santiagomd11/Proyecto-bola-balanza---Taller-de-control/documentos/Proyecto_bola_balanza_Taller_control__Monta_o_Diaz.pdf

# Proyecto Bola-balanza-Taller de control

V´ıctor Santiago Montano Diaz - ˜ | vs.montano@uniandes.edu.co

## Universidad de los Andes

Departamento de Ingenier´ıa Electrica y Electr ´ | onica ´

### Abril de 2020

## 1. Diagrama de bloques del sistema de control

Se cuenta con tres niveles los cuales se muestran a continuacion: ´

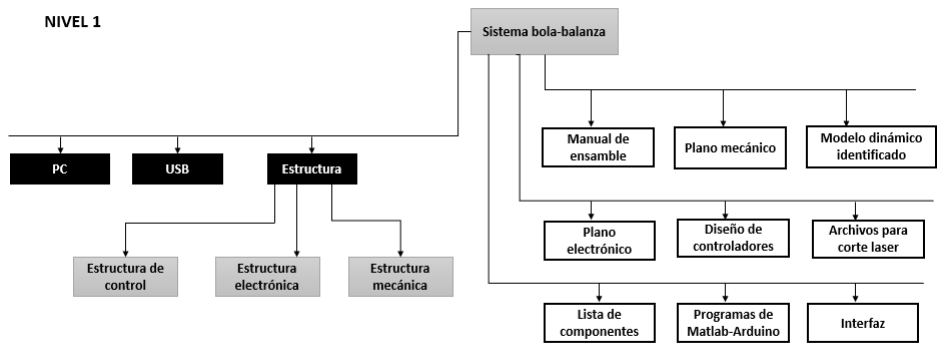
[picture p1: figure]

Figura 1: Nivel 1

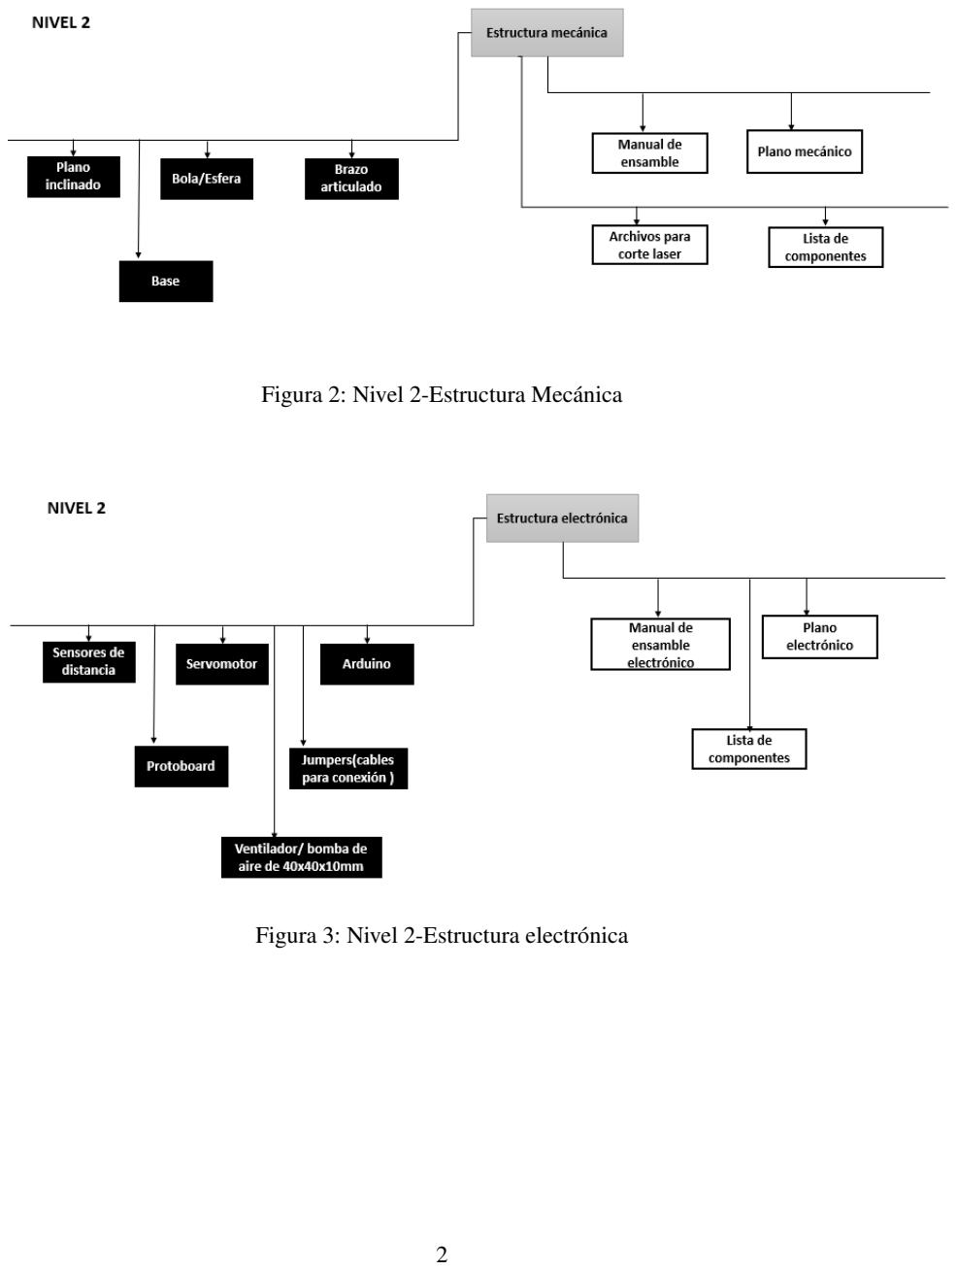
[picture p2: page 2]

Figura 2: Nivel 2-Estructura Mecanica ´

Figura 3: Nivel 2-Estructura electronica ´

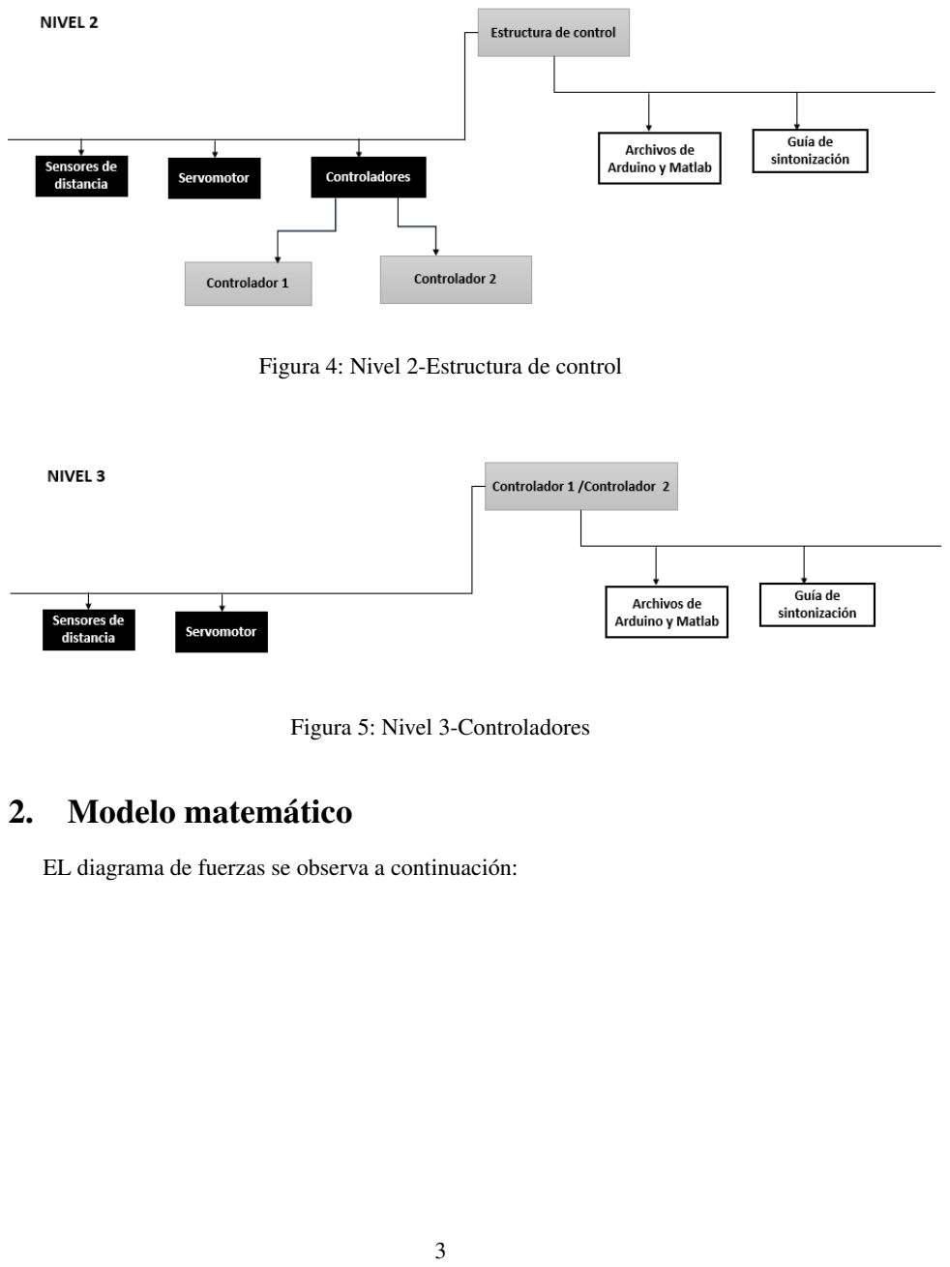
[picture p3: page 3]

Figura 4: Nivel 2-Estructura de control

Figura 5: Nivel 3-Controladores

## 2. Modelo matematico ´

EL diagrama de fuerzas se observa a continuacion: ´

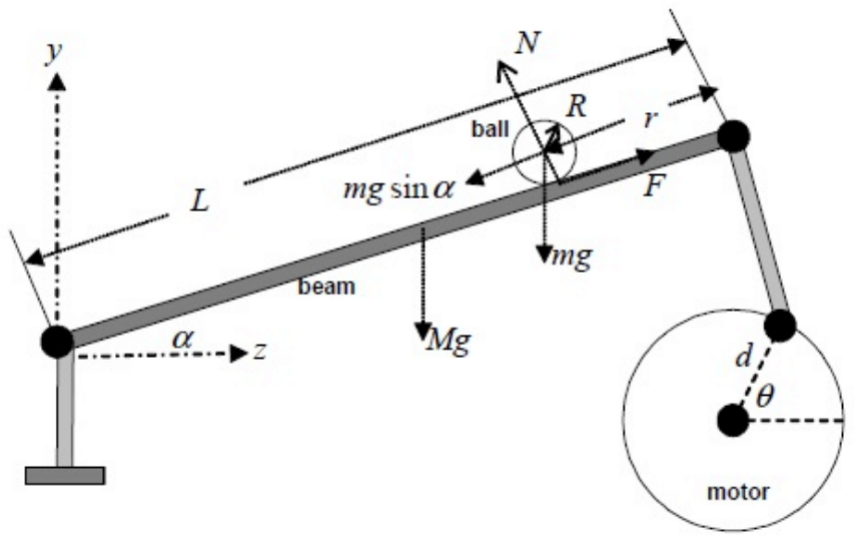
[picture p4: figure]

Figura 6: Diagrama de fuerzas

Teniendo en cuenta esto y la ecuacion de Euler-Lagrange se procedi ´ | o a encontrar el mo- ´
delo dinamico del sistema. Primero se identificaron las energ ´ | ´ıas cineticas y potenciales como ´
sigue:
T1 : Energ´ıa cinetica de la bola ´ | −→ T1 =

1
2m·V

2 +
1/2 Jbolaw

2
bola

x = r· cos(α) −→ vx = x

0 = r

0
cos(α)−rα

0
sen(α)
y = r·sen(α) −→ vy = y

0 = r

0
sen(α) +rα

0
cos(α)

V

2 = v

2
x +v

2
y = (r

0
)

2 +r

2
(α

0
)

2

T1 =

1
2m·((r

0
)

2 +r

2
(α

0
)

2

) + 1
2

Jbola(

r

0
R

)

2

T2 : Energ´ıa cinetica de la balanza ´ | −→ T2 =

1
2

Jbalanzaw

2
balanza =

1
2

Jbalanza(α

0
)

2

U1 : Energ´ıa potencial de la bola −→ U1 = m· g ·r·sin(α)

U2 : Energ´ıa potencial de la balanza −→ U2 = M · g ·L ·sin(α)

T =

1
2

m·((r

0
)

2 +r

2
(α

0
)

2

) + 1
2

Jbola(

r

0

R

)

2 +

1
2

Jbalanza(α

0
)

2

U = m· g ·r·sin(α) + M · g ·L ·sin(α)

L = T −U =

1
2

m·((r

0
)

2 +r

2
(α

0
)

2

) + 1
2

Jbola(

r

0

R

)

2 +

1
2

Jbalanza(α

0
)

2 −m· g ·r·sin(α)− M · g ·L ·sin(α)

(1)

Por Euler-Lagrange se tiene que:

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
= 0 | (2)

Aplicando esto se obtiene:

dL
dr⁰

= m(r

0
)

2 +Jbola(

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
) = (m+

Jbola
R²

)r

00

dL
dr

= mr(α

0
)

2 −mgsin(α)

(m+

Jbola
R²

)r

00 −mr(α

0
)

2 +mgsin(α) = 0

(3)

Finalmente, teniendo en cuenta que para angulos pequenos ˜ sin(α) ≈ α, Lα ≈ d · θ y lineali-zando alrededor de α = 0 y transformando todo al dominio de Laplace se obtiene que:

(m+

Jbola
R²

)s

2R(s) +mg(

d ·Θ(s)
L | ) = 0

R(s)
Θ(s)

= −

mgd
L(m+

Jbola
R²

)s

2 | (4)

Remplazando los valores de la ecuacion con los valores reales de la planta se obtuvo la ´ siguiente funcion de transferencia: ´

R(s)
Θ(s)

= G(s) = −0.672
s

2

Se simulo la respuesta al escalon unitario a lazo abierto en simulink obteniendo los siguientes resultados:

Figura 7: Diagrama de bloques- respuesta a lazo abierto

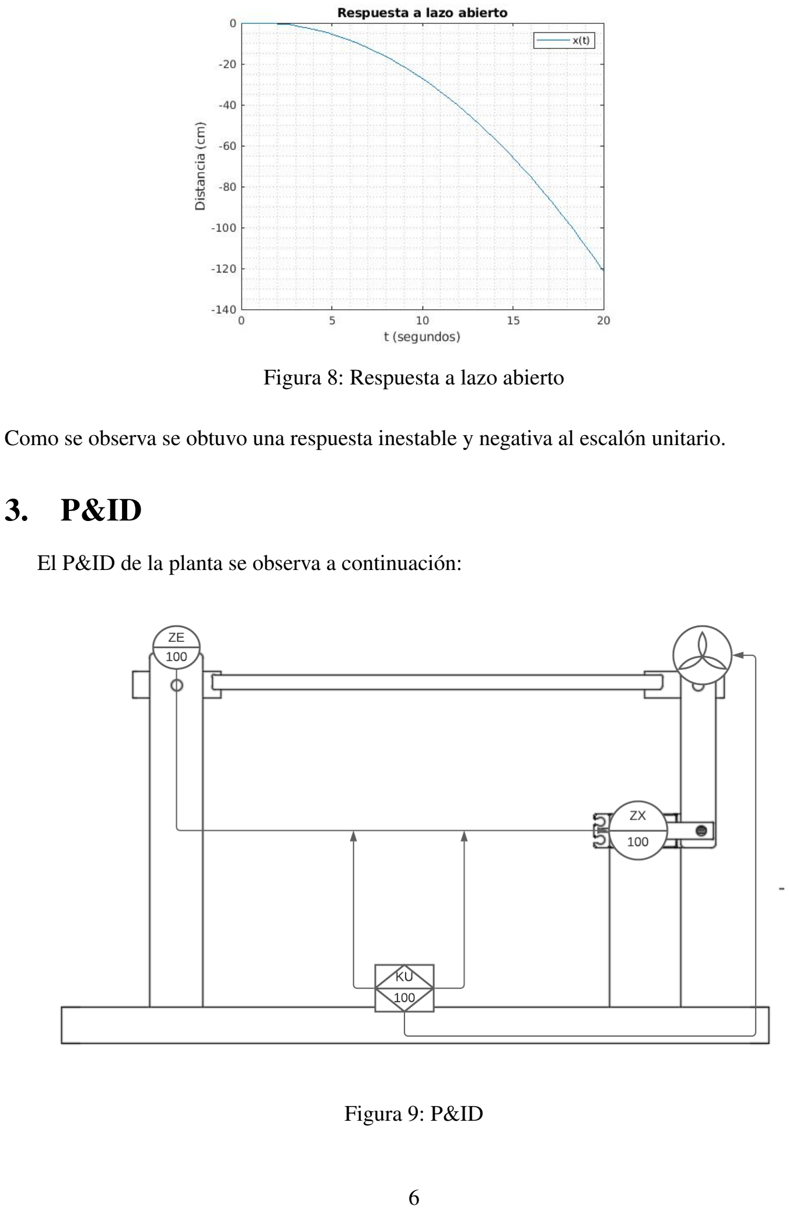
[picture p5: page 6]

Figura 8: Respuesta a lazo abierto

Como se observa se obtuvo una respuesta inestable y negativa al escalon unitario. ´

## 3. P&ID

El P&ID de la planta se observa a continuacion: ´

Figura 9: P&ID

Se cuenta con los siguientes elementos en la planta:

ZE: Sensor de distancia

KU: Microcontrolador

ZX: Servomotor

Ventilador

## 4. Plano mecanico ´

El plano mecanico y el modelado 3D de la planta se realizo con la ayuda del software ´
fusion 360, el modelo 3D de la planta se observa a continuaci ´ | on: ´

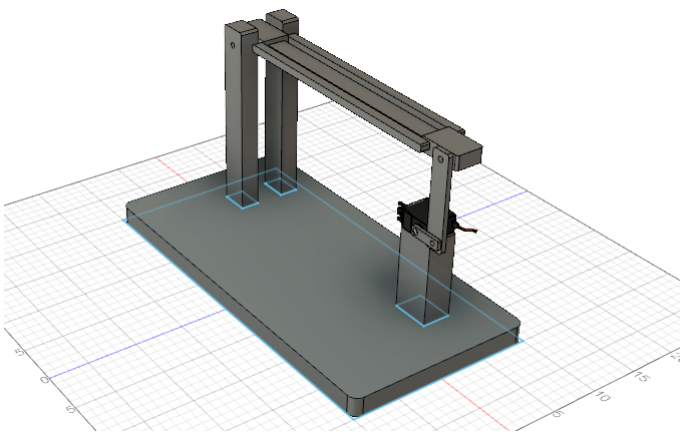
[picture p6: figure]

Figura 10: Modelo 3D de la planta

La planta montada se observa a continuacion: ´

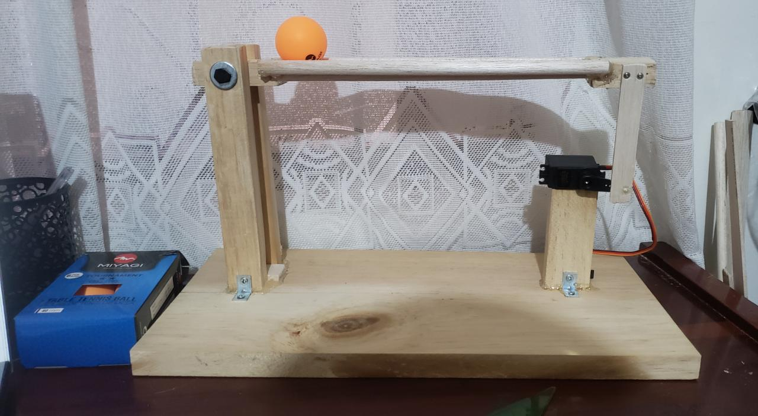
[picture p7: figure]

Figura 11: Planta

El plano mecanico y los archivos para corte l ´ | aser se anexaron al final del documento. ´
5. Esquematico electr ´ | onico ´
El esquematico electr ´ | onico se observa a continuaci ´ | on: ´

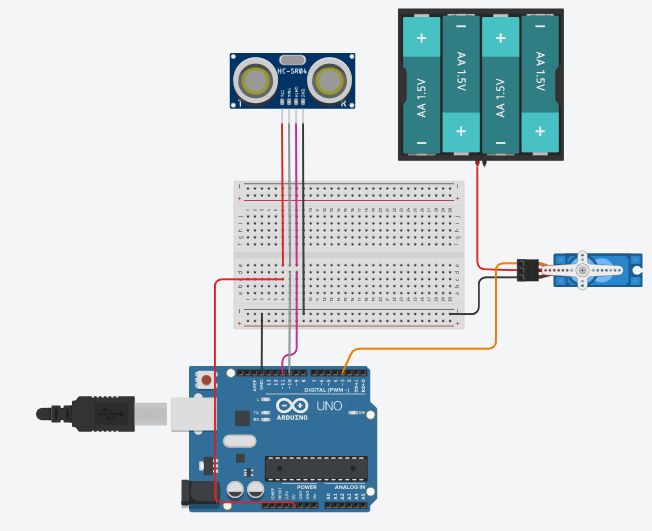
[picture p8: figure]

Figura 12: Esquematico electr ´ | onico ´

los dispositivos electronicos utilizados se enumeran a continuaci ´ | on: ´

Arduino Uno

Sensor de distancia ultrasonico HC-SR04 ´

Servomotor MG945

4 bater´ıas recargables de 1.5v

Jumpers para conexion´

Mini-protoboard

## 6. Identificacion a partir de los datos ´

La identificacion de la planta se realizo ubicando la bola de ping pong en el setpoint(La ´ mitad de la viga) y el servo de tal manera que la planta quede sin inclinacion(servo en 125°), ´
se realizo una pequena variaci ˜ | on del ´ | angulo de servo y se tomaron datos datos de distancia. ´
Para una variacion de 125° a 115° (-10° de variaci ´ | on) se obtuvo la siguiente respuesta: ´

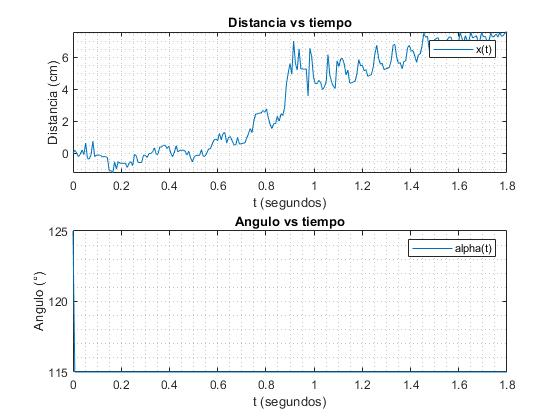
[picture p9: figure]

Figura 13: Respuesta real de la planta

Como se observa ante una variacion negativa del ´ | angulo del servo se obtiene una respues- ´
ta positiva, lo cual coincide con el modelo teorico. ´

Se realizo una regresion con el fin de estimar: ´

xˆ(t) = θ ·t

2

Se estimo el parametro ´ | θ que mejor se ajustaba a los datos , obteniendo el siguiente resultado: xˆ(t) = 3.045 ·t
| 2
la grafica del ajuste con los datos reales se observa a continuaci ´ | on: ´

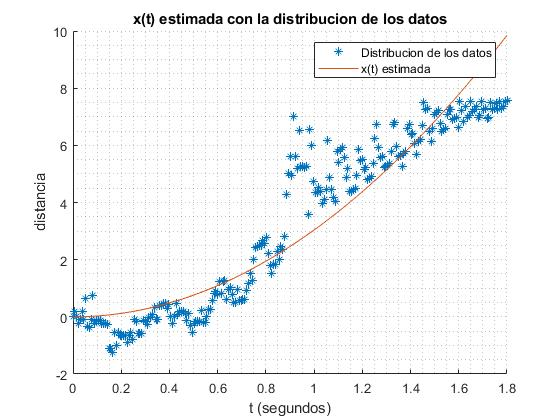
[picture p10: figure]

Figura 14: x(t) estimada con los datos reales

Teniendo esta estimacion se procedi ´ | o a calcular la funci ´ | on de transferencia del sistema: ´

ENTRADA:

α(t) = (115−125)u(t)

L

−→ A(s) = −10
s

SALIDA:

x(t) = 3.045 ·t

2 L

−→ X(s) = 3.045 · 2!
s

3
Finalmente con este resultado se obtiene:

G(s) = X(s)
A(s)

=

6.09
s

3
−10
s
G(s) = −0.609
s

2
como se observa este resultado se asemeja bastante con el resultado obtenido teoricamente. ´

## 7. Diseno del controlador PID ˜

Dado que la funcion de trasferencia real se asemeja bastante a la obtenida te ´ | oricamente ´
se decidido sintonizar con la funcion te ´ | orica. Para sintonizar se sigui ´ | o el siguiente diagrama ´
de bloques:

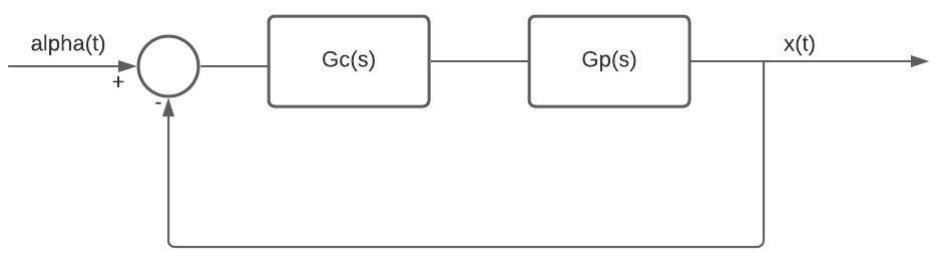
[picture p11: figure]

Figura 15: lazo cerrado con controlador

Se obtuvo la funcion de trasferencia en lazo cerrado para fines de sintonizaci ´ | on, teniendo ´
en cuenta que para este lazo se tiene que esta es igual a:

T(s) = Gc(s)Gp(s)
1+Gc(s)Gp(s)

remplazando Gc(s) = Kp +

Ki

s +Kds y Gp(s) = −0.672
s

2 y simplificando se obtuvo el siguiente resultado:
T(s) = | −0.672(Kds

2 +Kps+Ki)

s

3 −0.672 ·Kds

2 −0.672 ·Kps−0.672 ·Ki

En este caso se buscaron Kd,Kp,Ki de tal manera que todos los polos de la funcion de trans- ´ ferencia en lazo cerrado se situaran -1, lo cual garantiza la estabilidad. Se busco lo siguiente:

s

3 −0.672 ·Kds

2 −0.672 ·Kps−0.672 ·Ki = (s+1)

3

s

3 −0.672 ·Kds

2 −0.672 ·Kps−0.672 ·Ki = s

3 +3s

2 +3s+1

finalmente por comparacion se obtuvo: ´

−0.672 ·Kd = 3 −→ Kd = −4.46

−0.672 ·Kp = 3 −→ Kp = −4.46

−0.672 ·Ki = 1 −→ Ki = −1.48

8. Implementacion del controlador-Simulaci ´ | on´

Se implemento el controlador en simulink con las constantes calculadas previamente, obteniendo los siguientes resultados:

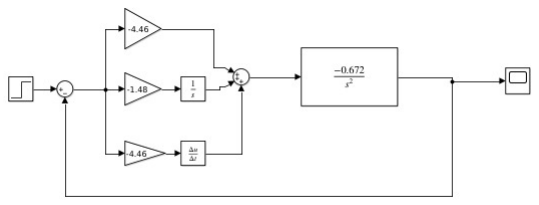
[picture p12: figure]

Figura 16: Controlador PID en simulacion´

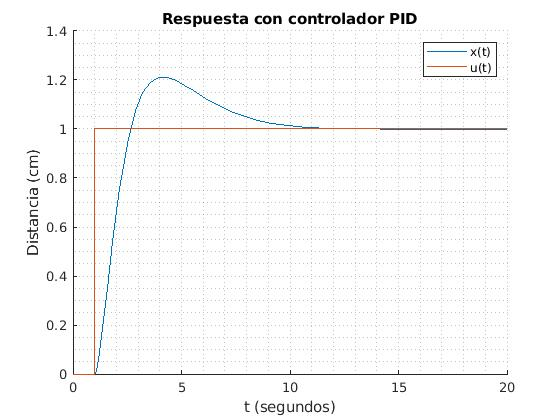
[picture p13: figure]

Figura 17: Respuesta del sistema con el controlador PID

Como se observa el controlador garantiza la estabilidad del sistema y el seguimiento del setpoint en estado estable.

## 9. Implementacion del controlador- En planta ´

Los resultados obtenidos en la planta se observan a continuacion: ´

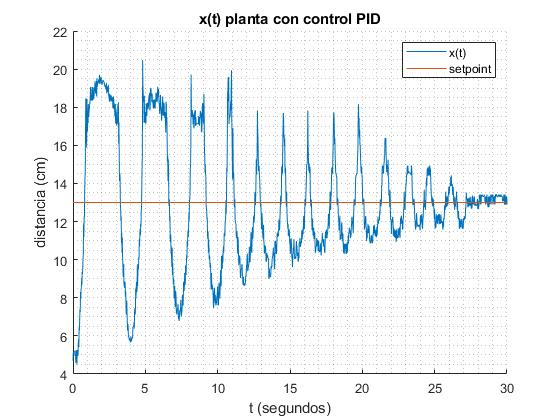
[picture p14: figure]

Figura 18: Respuesta de la planta con el controlador PID

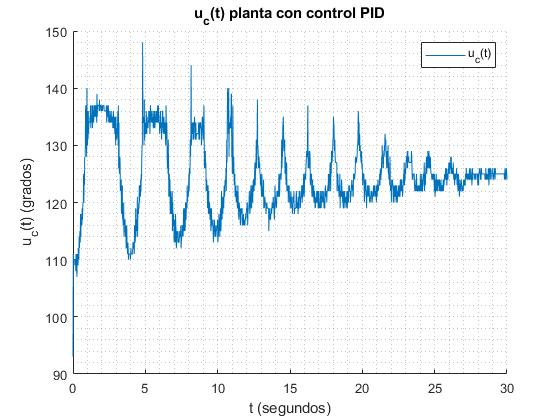
[picture p15: figure]

Figura 19: Senal de control ˜

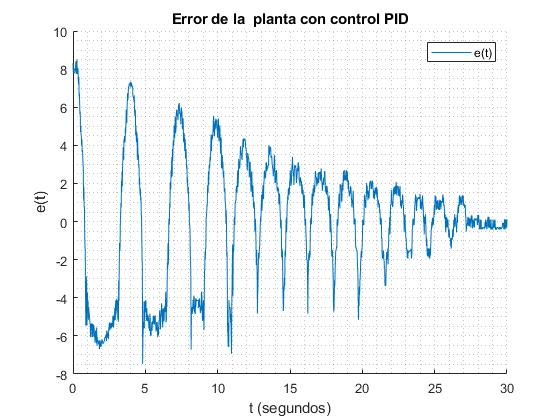
[picture p16: figure]

Figura 20: Error

Como se observa la respuesta del controlador en planta fue algo oscilatoria, sin embar-go,como se observa en la figura 18 el sistema logra estabilizarse en la mitad de la viga(aprox 13cm) y se logra un error en estado estable de aproximadamente 0 como se puede ver en la
figura 20. Por otra parte, se observa que la senal de control que en este caso es el ˜ | angulo del ´
servo se estabiliza en 125° aproximadamente.

## 10. Recursos

Los archivos de Arduino, Matlab y del modelo 3d se encuentran disponibles en el siguiente repositorio:

https://github.com/santiagomd11/Proyecto-bola-balanza---Taller-de-control

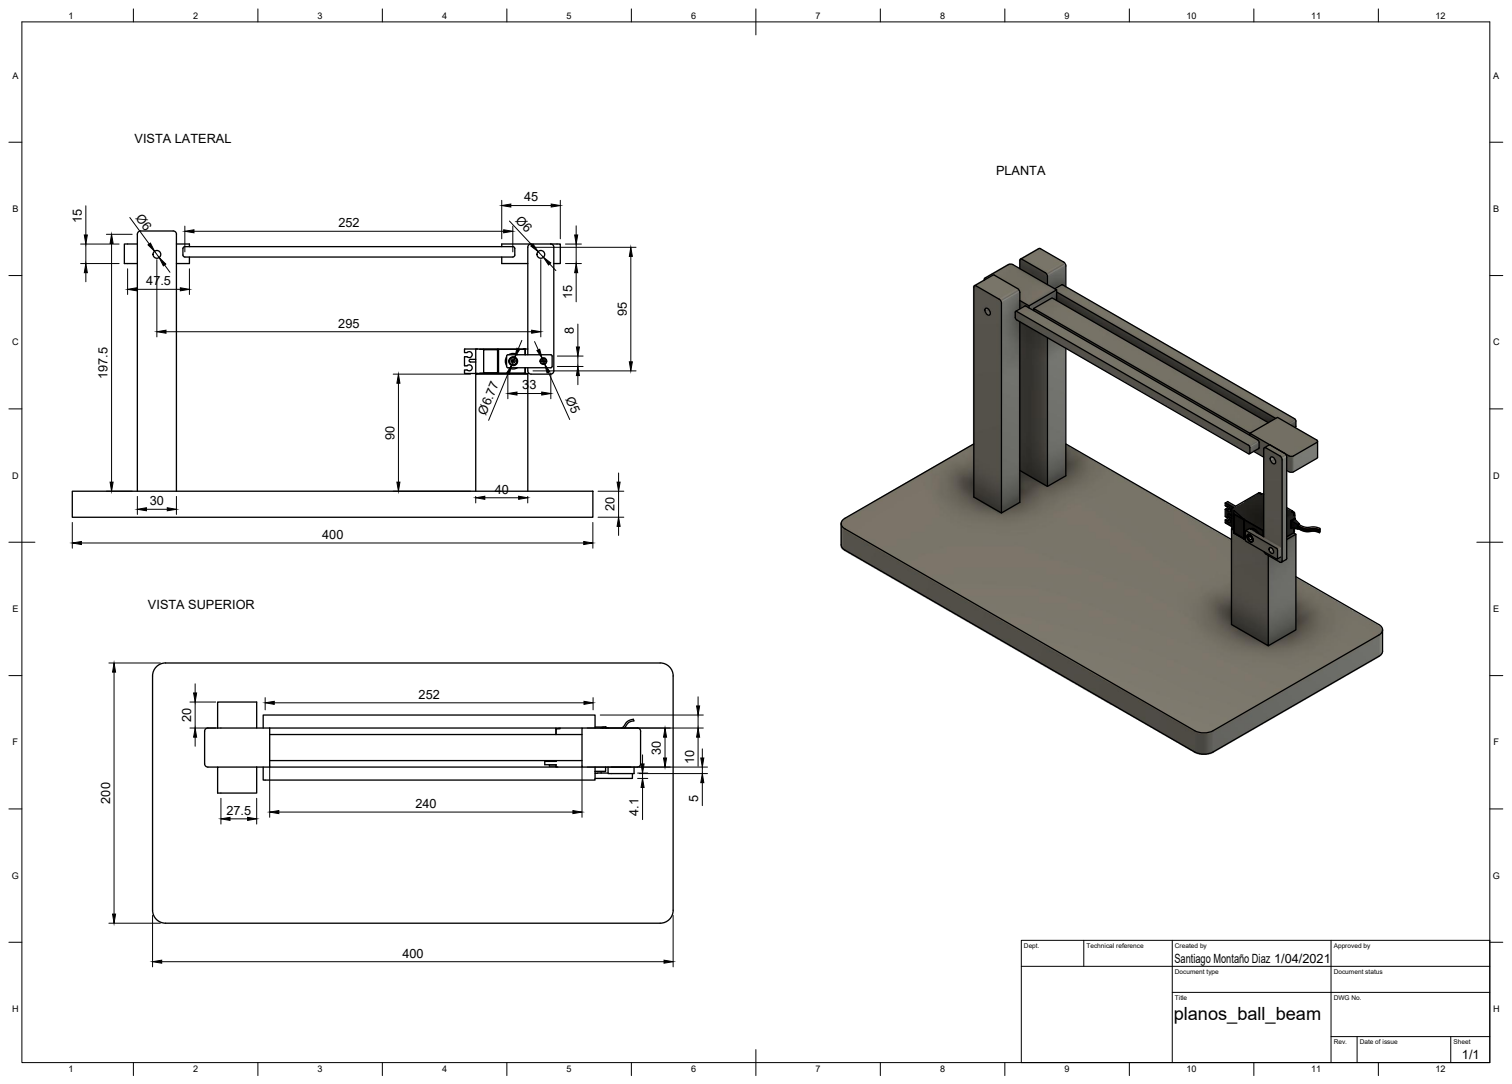
[picture p17: page 15]
Dept.; Technical reference; Created by; Approved by; VISTA LATERAL; 40 ¹⁹⁷.5; VISTA SUPERIOR 200; PLANTA

Santiago Montaño Diaz

Document type | Document status

Title planos_ball_beam | DWG No.

Rev. | Date of issue | Sheet 1/1

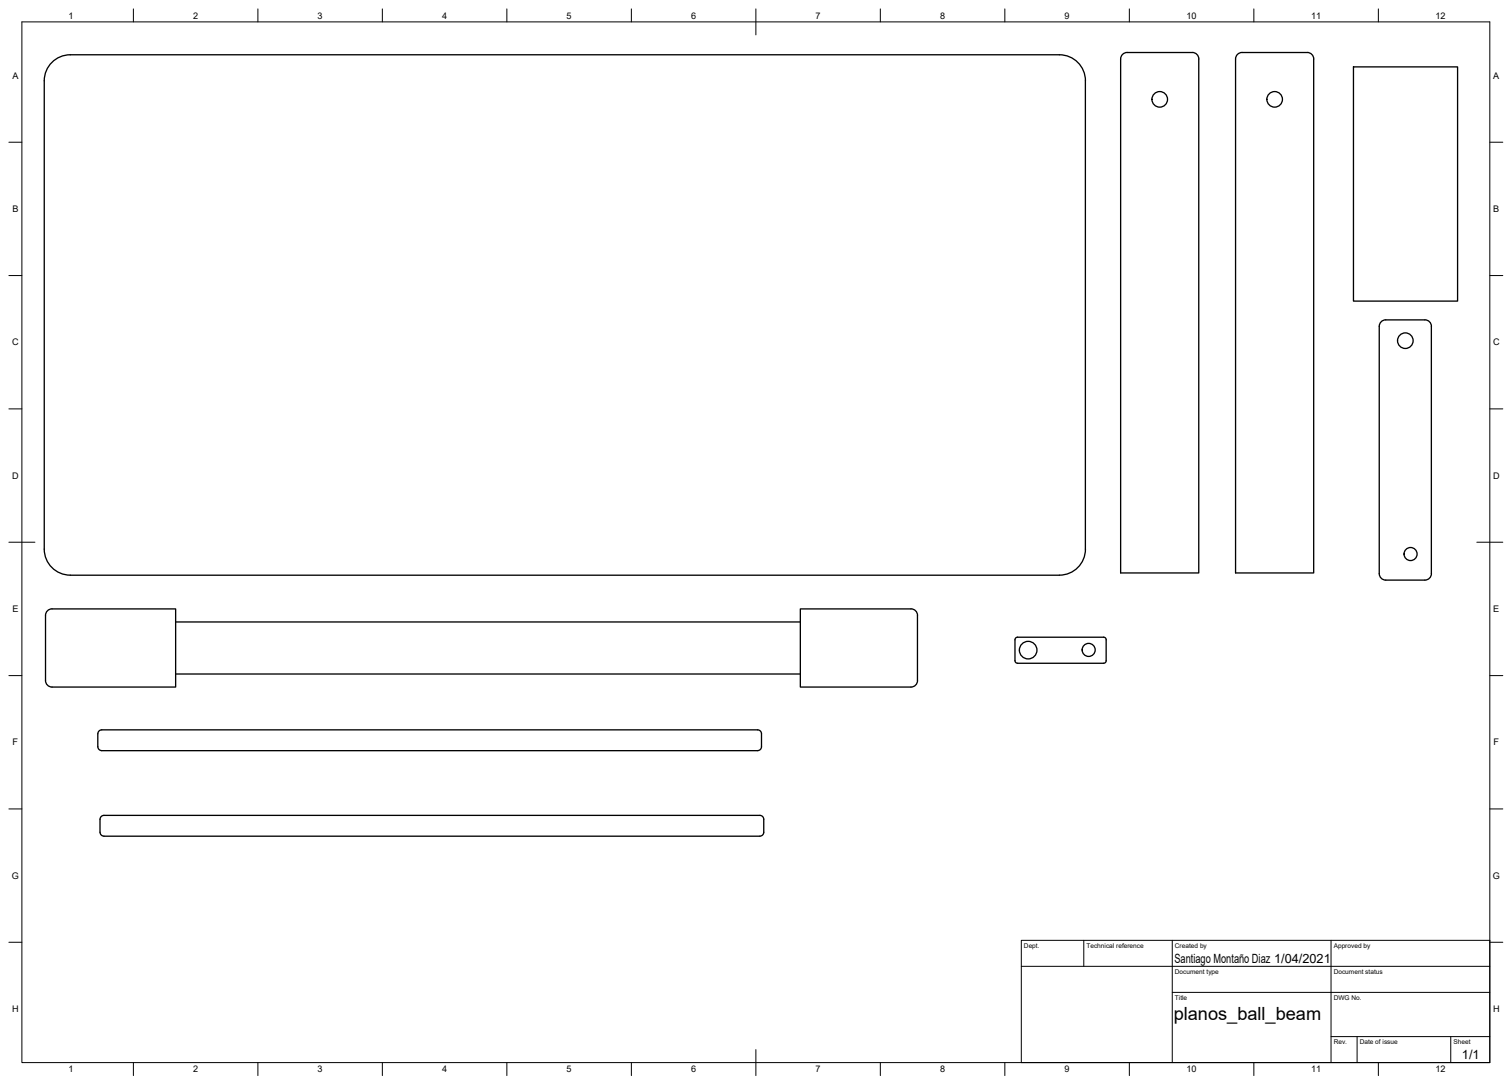
[picture p18: page 16]
Dept.; Technical reference; Created by; Approved by

Santiago Montaño Diaz

Document type | Document status

Title planos_ball_beam | DWG No.

Rev. | Date of issue | Sheet 1/1
