santiagomd11/Proyecto-bola-balanza---Taller-de-control/(list of files, cad)

Other CAD files:
diseños/Modelo_3d_planta.f3d
