santiagomd11/Proyecto-bola-balanza---Taller-de-control/diseños/planos_ball_beam.pdf

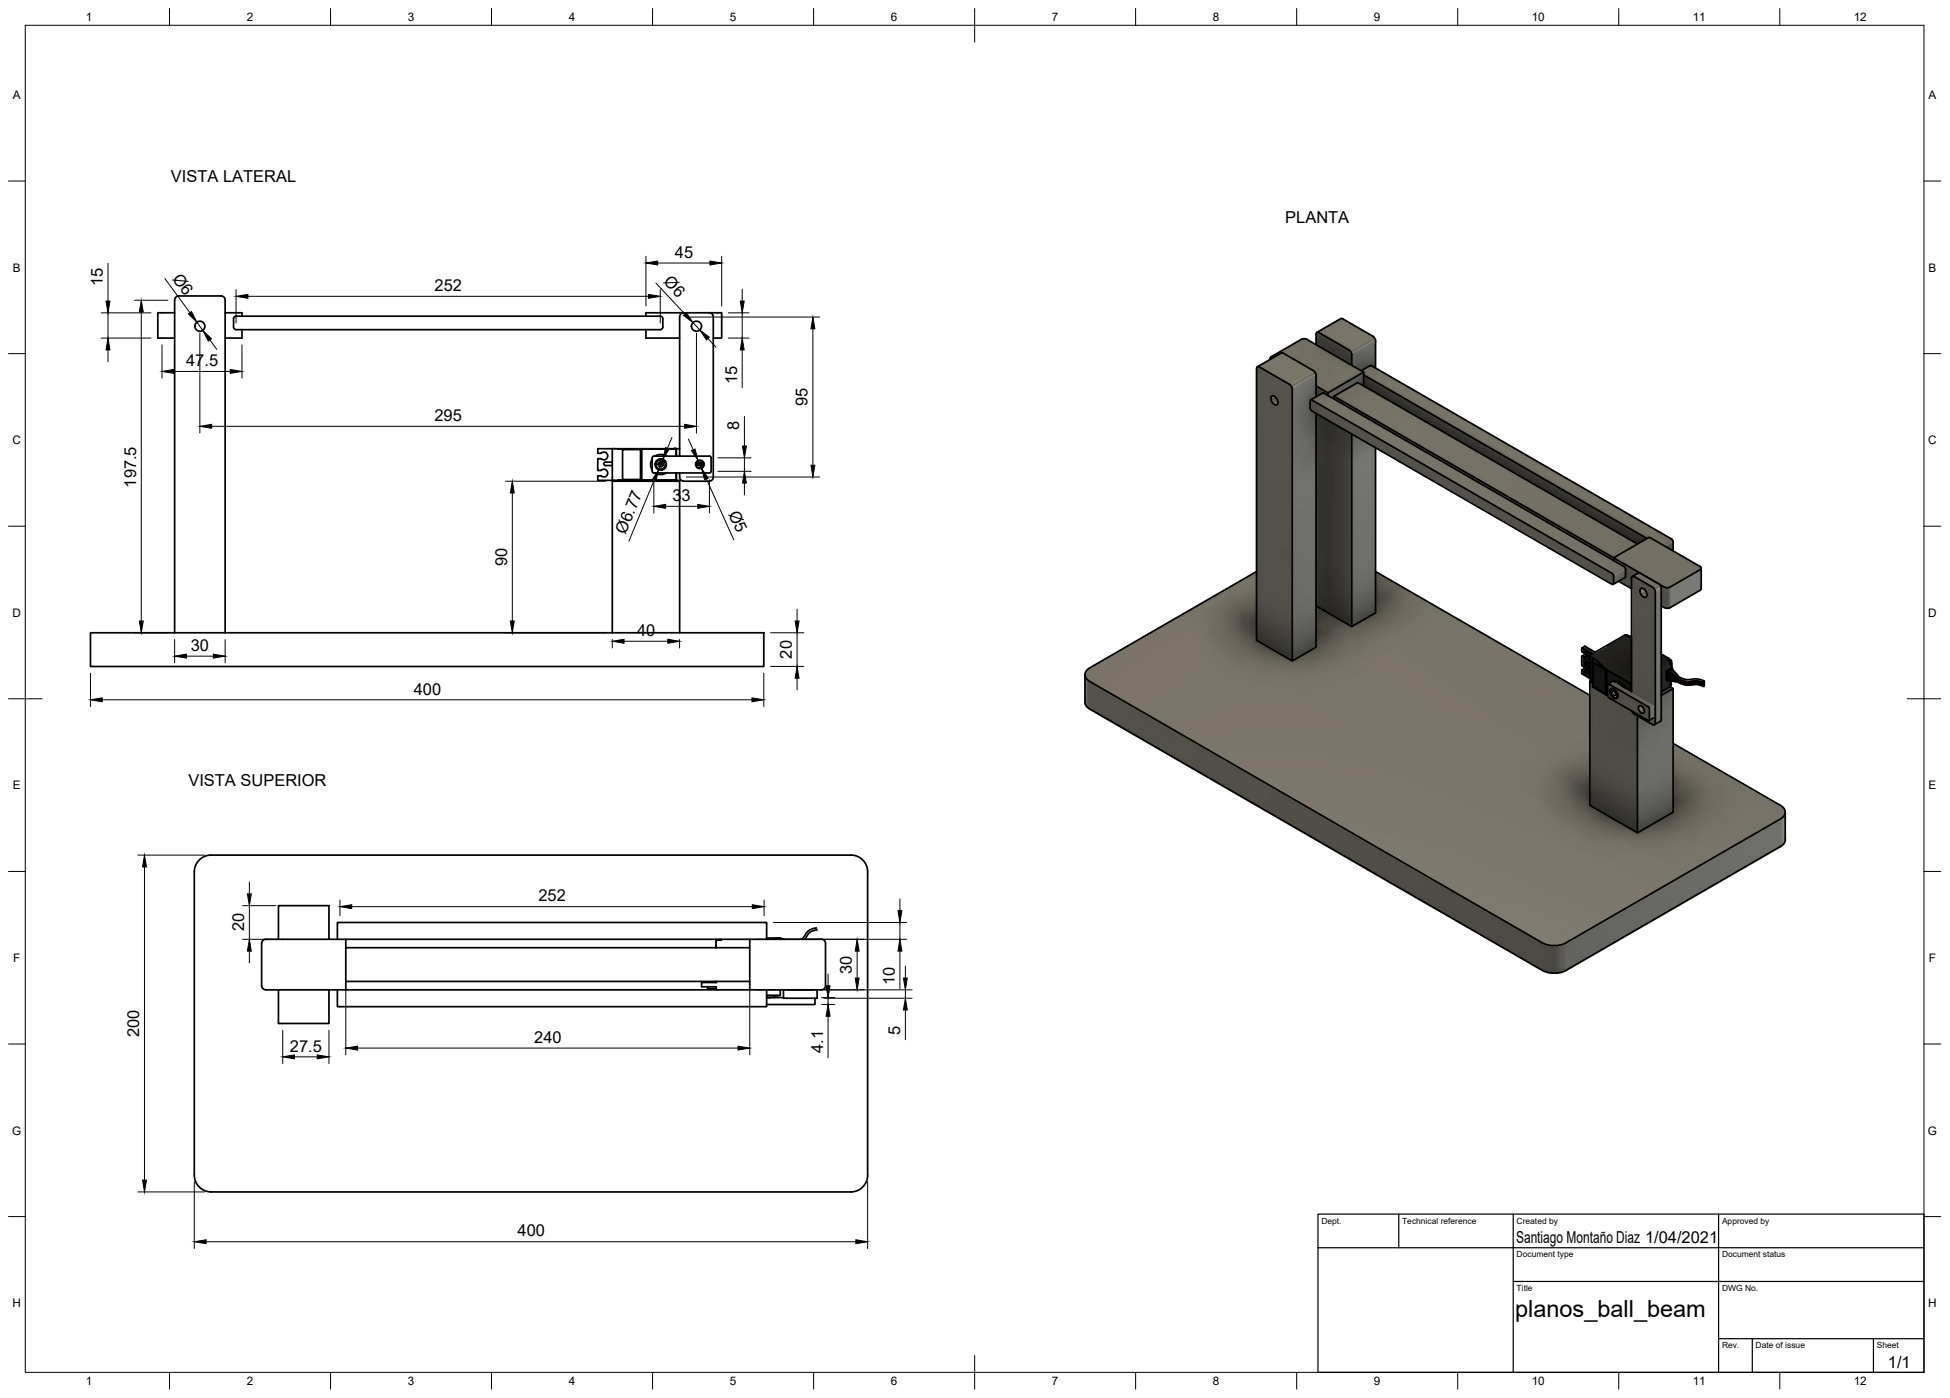
[picture p19: page 1]
VISTA LATERAL; VISTA SUPERIOR 200

Dept. | Technical reference | Created by Santiago Montaño Diaz 1/04/2021 | Approved by

Document type | Document status

Title planos_ball_beam | DWG No.

Rev. | Date of issue | Sheet 1/1
